electrical-pro/ESP32_Robot/(threads)

Thread 1 (2020-12-18):

DRV8825 Solder and Motor Torque

elciomsantana, 2020-12-18:
I was building a robot inspired by what you were inspired by, but with your code I managed to balance it, but I couldn't control it via WIFI, as it always falls, do you think the DAC soldier on the DRV8825 could be the problem?

Currently the DAC is only on the negative, as shown in the attached photo ...
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

Another point, when removing the potentiometer and soldering it to the DAC, do I also need to solder this tiny wire to the CHIP SMD? How did you do it?
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

Thanks for the help, I developed a head with 1 ultrasonic sensor and 1 laser that turns 180 degrees horizontally and 120 degrees vertically, so it can move around alone.

I have esp32cam also that I intend to attach to that head in the future.

Deimos1994, 2020-12-19:
@elciomsantana Hi, what do you mean by "Currently the DAC is only on the negative" ?
Did you connect everything according to the circuit? you need to remove the trimmer potentiometers on DVR8825 modules and connect a wire to the resistors (as shown on my circuit), without it the robot is not very stable.
No, you don't need to solder a tiny wire to the CHIP SMD, I did not see any difference with it or without it.

elciomsantana, 2020-12-21:
https://user-images.githubusercontent.com/76231121/102816179-55ed8f00-43ac-11eb-9a8a-4f636d67fb22.mp4

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

elciomsantana, 2020-12-22:
I removed the potentiometer and connected the DAC. Thanks!

Is there a problem connecting the DRV8825 drivers to the 5.5V current instead of the 3.3V ESP32 DEV kit itself?
I say in relation to the current calculation of the DAC because I am currently connecting everything in 5.5V.

Robot is standing still, I can rotate him very slowly by remote control, but if I put him to move forward or turn fast he falls.
If I push it, it gets out of control and falls, you know what it could be?

The diameter of the wheel is approximately 12cm, and the height of the MPU is 50cm, I do not know if that influence.

Deimos1994, 2020-12-23:
@elciomsantana On the video it seems like the only one stepper motor is working. Check the second motor, make sure it works.
`Is there a problem connecting the DRV8825 drivers to the 5.5V current instead of the 3.3V ESP32 DEV kit itself?`
Well, I did not test it with 5V. Why do you even use 5.5V for DRV8825 logic? I just don't understand it. Use 3.3V like in the original circuit, DRV8825 works fine with 3.3V.

elciomsantana, 2020-12-23:
Yes, in this video I was operating with 1 stepper motor only, but this has already been solved, I had burnt a DRV8825.

I turned on 5.5v because it was simpler to connect, and the MPU works better with voltage above 3.3v with longer wires.

I will do this modification, another thing that is different in my project, is the FAULT wire that I did not connect at all, and the SLP + RST jumper are connected on the 5v as shown in the image below

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

Two StepMotors Working now:

https://user-images.githubusercontent.com/76231121/102999021-0cfe1d80-4507-11eb-9238-99e63c5bd593.mp4

No potentiometer :
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

Deimos1994, 2020-12-23:
@elciomsantana I think it should work with all your modification.
Did you tune PID controller values for your robot?

elciomsantana, 2020-12-23:
I change this values but not success
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

I did all the modifications but it is still unstable when I try to use the remote control or push it ...
The whole system is running with the ESP32 3.3v

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

Deimos1994, 2020-12-23:
@elciomsantana `I change this values but not success`
1. Don't change that, set it as it was before.
2. Then go to http://192.168.4.1/
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
Change PID tuning: Angle and Pos and make the robot stable
3. after that save your values in the scetch
```cpp
  pidAngle.setParameters(1.2,0.57,0.19,5.8);
  pidPos.setParameters(1.1,1.85,0.72,20);
  pidSpeed.setParameters(1.8,3.6,0.65,0.6);
```
4. Flash the robot to make the changes permanent

Thread 3 (2022-05-02):

Details on removing the potentiometer and soldering the wire

Tomasonx, 2022-05-02:
I have already tried on 3 pieces of DRV8825.

Can you detail the process and possibly check if the soldering was correct?

electrical-pro, 2022-05-03:
@Tomasonx, Hello, what is the problem exactly?, just use a soldering iron, use flux and solder and remove the potentiometer.
then solder the wire like on the picture
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

everything according to the circuit
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

Tomasonx, 2022-05-04:
1. Removing the potentiometer = no problem.
2. After that you have 3 points, VCC, GND, Output.
From the picture I understand that you are soldering only with point 3 (Output), right?
Because it's a very small point, how do you test (measure) that you're soldering ok?

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

electrical-pro, 2022-05-04:
@Tomasonx, yes only point 3 (Output). You can use a magnifying glass to check visually.
You can use a multimeter to check if you don't have a short circuit between VCC, GND, and Output.
If you want to check more you can follow that PCB trace.

Thread 4 (2022-09-25):

Stepper speed issue

antalpromille, 2022-09-25:
Hi,

I have been trying to get this code to run correctly on my robot but I cannot get it to move. Right now, i only have solid light on the leds attached to the step pins, and I can get alternating light on the direction pin leds. I can hear the motors trying to work, but no movement.

I do not have the voltage/current detection unit so I have just tricked the system by saying that the lowest voltage is 12.

Should i expect some kind of flickering on the step pin leds? Or is this to fast to be seen by the human eye? I feel a bit stuck right now, so any help is appreciated.

antalpromille, 2022-10-11:
Just an update on the progress:
I managed to get the motors running, turned out I had step and dir pins wrong on my PCB design.

I did hear the motors buzzing once every second, and now when they are turning it seem like the direction of the motors is just updating ~once per second, so I still need to figure this out. Any ideas?

Thread 5 (2022-11-16):

Compile error hwcrypto/sha.h: No such file or directory

mjkdz, 2022-11-16:
Compile error hwcrypto/sha.h: No such file or directory

mjkdz, 2022-11-16:
Replace the latest arduinoWebSockets ESPAsyncWebServer library and compile properly
